GershowLab/trig3_board_pllphase_de0nano-firmware/board/de0-extender-pll/trig3_board_de0-nano - LTC6957.brd

## EAGLE design board/de0-extender-pll/trig3_board_de0-nano - LTC6957.brd (2023-12-06)

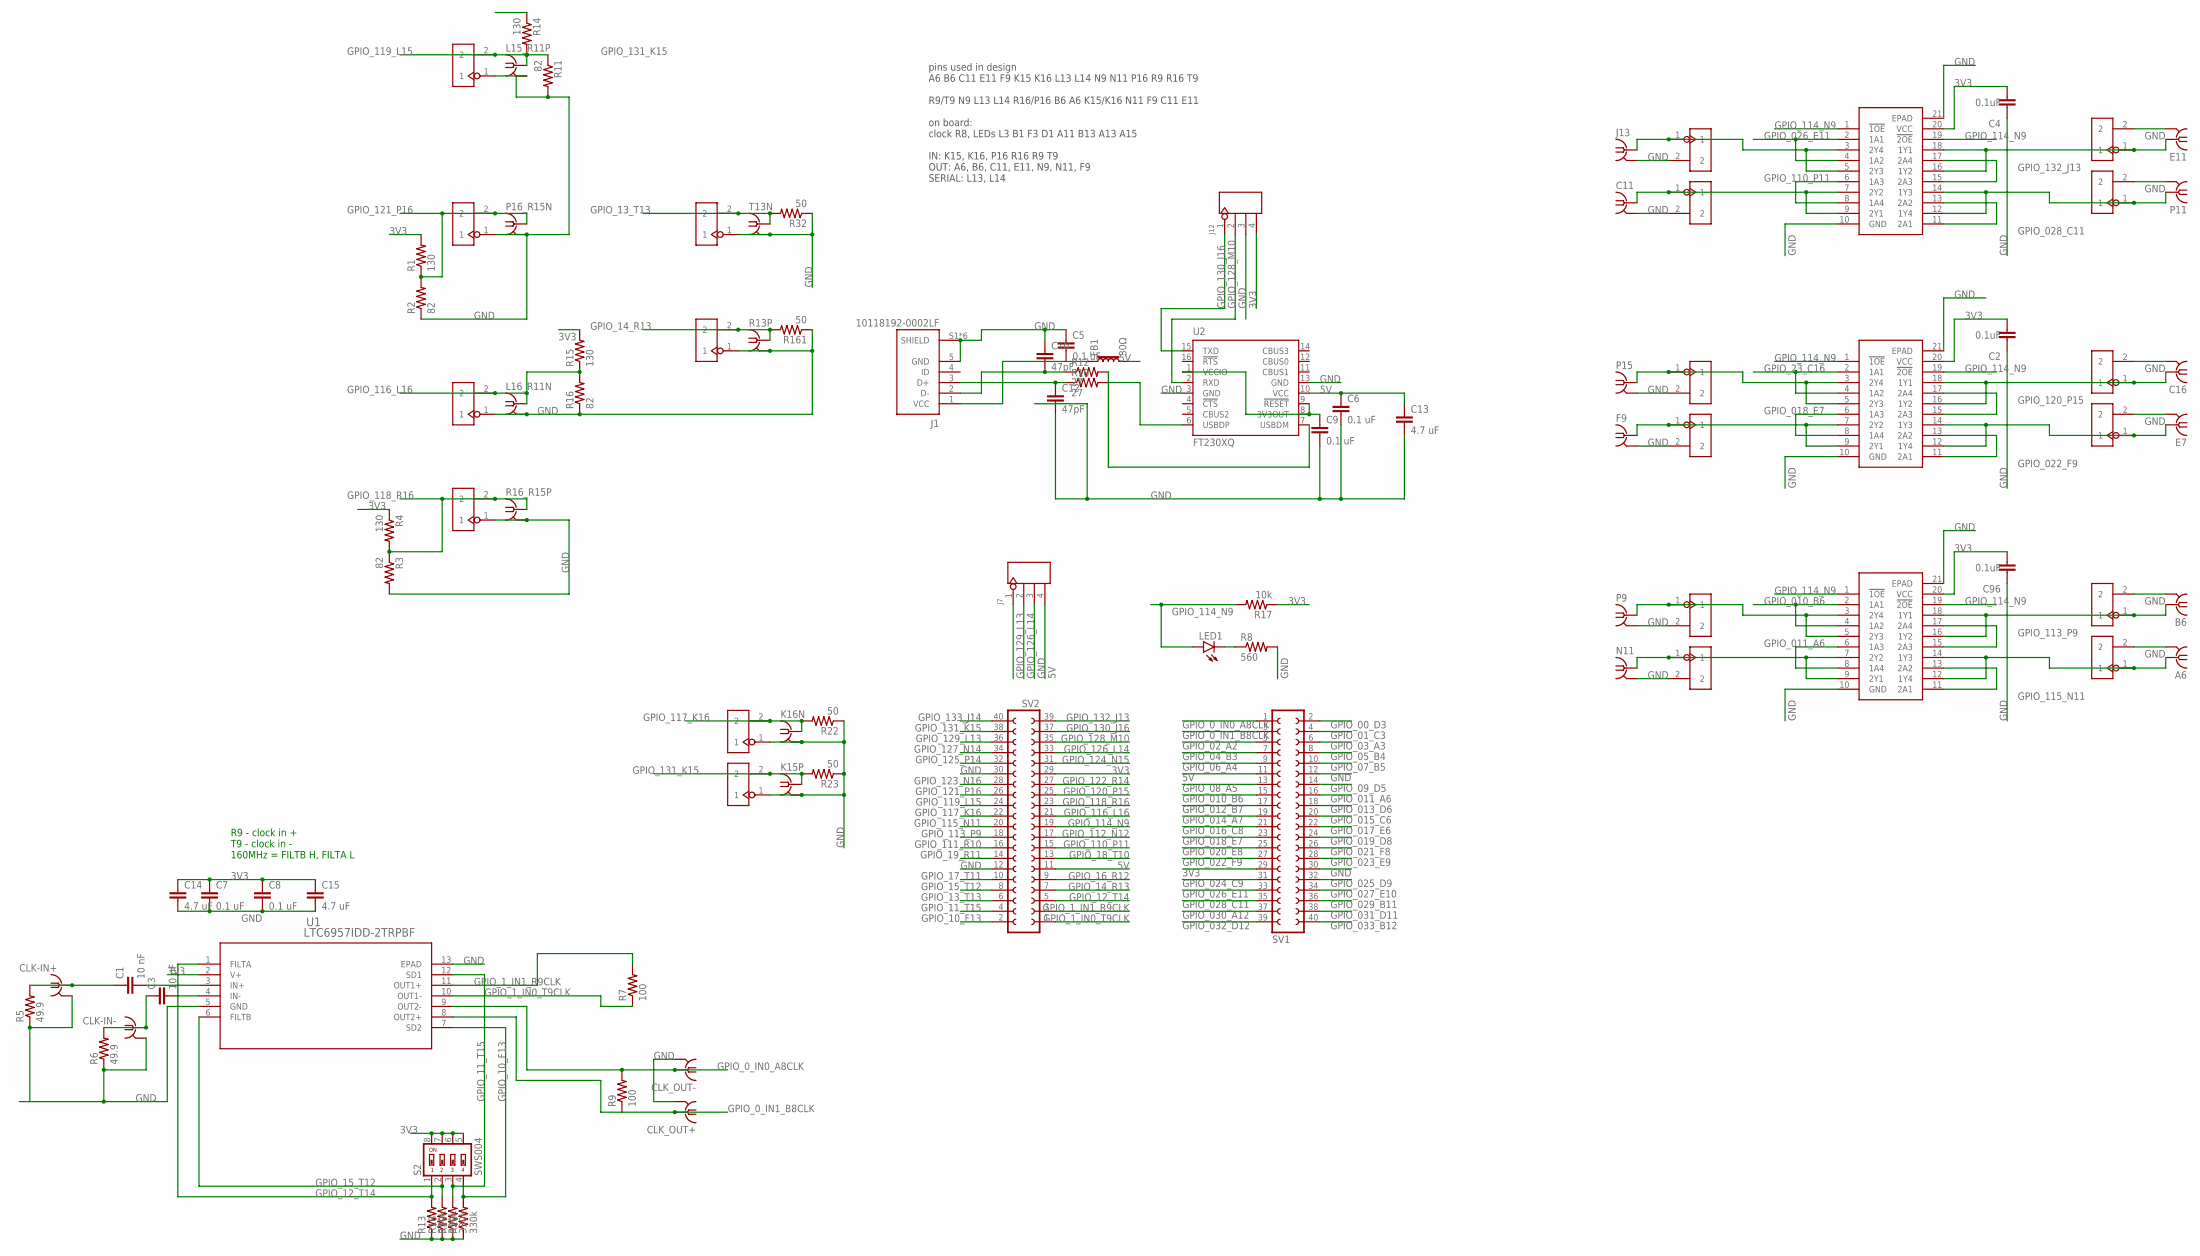
[picture p1: schematic trig3_board_de0-nano - LTC6957.sch]

Parts:
A6: BU-SMB-V; LCSC_PART# C496549
B6: BU-SMB-V; LCSC_PART# C496549
C1, C3: 10 nF; C0603; LCSC_PART# C57112
C2, C4, C96: 0.1uF; C0603; LCSC_PART# C14663
C5, C6, C7, C8, C9: 0.1 uF; C0603; LCSC_PART# C14663
C10, C12: 47pF; C0603; LCSC_PART# C1671
C11, C16: BU-SMB-V; LCSC_PART# C496549
C13, C14, C15: 4.7 uF; C0603; LCSC_PART# C19666
CLK-IN+: BU-SMB-V; LCSC_PART# C496549
CLK-IN-: BU-SMB-V; LCSC_PART# C496549
CLK_OUT+: BU-SMB-V; LCSC_PART# C496549
CLK_OUT-: BU-SMB-V; LCSC_PART# C496549
E7, E11: BU-SMB-V; LCSC_PART# C496549
F9: BU-SMB-V; LCSC_PART# C496549
FB1: 30Ω; 0603; LCSC_PART# C1002
J1: 10118192-0002LF; AMPHENOL_10118192-0002LF; LCSC_PART# C132564
J7, J12: 4p-2.54; H4-2.54
J13: BU-SMB-V; LCSC_PART# C496549
J17, J23, J24, J32, J34, J38, J42, J43: 2p-2.54; H2-2.54
K15P, K16N: BU-SMB-V; LCSC_PART# C496549
L15_R11P, L16_R11N: BU-SMB-V; LCSC_PART# C496549
LED1: red; SML0805; LCSC_PART# C84256
N11: BU-SMB-V; LCSC_PART# C496549
OJ41, OJ42, OJ43, OJ44, OJ57, OJ58, OJ59, OJ60, OJ73, OJ74, OJ75, OJ76: 2p-2.54; H2-2.54
P9, P11, P15, P16_R15N: BU-SMB-V; LCSC_PART# C496549
R1, R4, R14, R15: 130; R0603; LCSC_PART# C22796
R2, R3, R11, R16: 82; R0603; LCSC_PART# C23255
R5, R6: 49.9; R0603; LCSC_PART# C23185
R7, R9: 100; R0603; LCSC_PART# C22775
R8: 560; R0805; LCSC_PART# C28636
R10, R12: 27; R0603; LCSC_PART# C25190
R13, R18, R19, R20: 330k; R0603; LCSC_PART# C23137
R13P, R16_R15P: BU-SMB-V; LCSC_PART# C496549
R17: 10k; AXIAL-0.3
R22, R23, R32, R161: 50; AXIAL-0.3
S2: SWS004; SMS-004; LCSC_PART# C221954
SV1, SV2: FE20-2
T13N: BU-SMB-V; LCSC_PART# C496549
U1: LTC6957IDD-2TRPBF; DFN-12_DD_LIT; LCSC_PART# C689878
U2: FT230XQ; QFN16; LCSC_PART# C128629
U3, U4, U5: SN74LVTH244ARGYR; RGY20_3P05X2P05; LCSC_PART# C2869480

Connections:
3V3: C2.2, C4.2, C7.1, C8.1, C14.1, C15.1, C96.2, J12.4, R1.2, R4.1, R14.1, R15.2, R17.P$1 (1), S2.5, S2.6, S2.7, S2.8, SV1.29, SV2.29, U1.2 (V+), U3.20 (VCC), U4.20 (VCC), U5.20 (VCC)
5V: C6.1, C13.1, FB1.2, J7.4, SV1.11, SV2.11, U2.10 (VCC)
GND: A6.2, A6.3 (2), A6.4 (2), A6.5 (2), B6.2, B6.3 (2), B6.4 (2), B6.5 (2), C2.1, C4.1, C5.1, C6.2, C7.2, C8.2, C9.2, C10.1, C11.2, C11.3 (2), C11.4 (2), C11.5 (2), C12.2, C13.2, C14.2, C15.2, C16.2, C16.3 (2), C16.4 (2), C16.5 (2), C96.1, CLK-IN+.2, CLK-IN+.3 (2), CLK-IN+.4 (2), CLK-IN+.5 (2), CLK-IN-.2, CLK-IN-.3 (2), CLK-IN-.4 (2), CLK-IN-.5 (2), CLK_OUT+.2, CLK_OUT+.3 (2), CLK_OUT+.4 (2), CLK_OUT+.5 (2), CLK_OUT-.2, CLK_OUT-.3 (2), CLK_OUT-.4 (2), CLK_OUT-.5 (2), E7.2, E7.3 (2), E7.4 (2), E7.5 (2), E11.2, E11.3 (2), E11.4 (2), E11.5 (2), F9.2, F9.3 (2), F9.4 (2), F9.5 (2), J1.5 (GND), J1.S1 (SHIELD), J1.S2 (SHIELD), J1.S3 (SHIELD), J1.S4 (SHIELD), J1.S5 (SHIELD), J1.S6 (SHIELD), J7.3, J12.3, J13.2, J13.3 (2), J13.4 (2), J13.5 (2), J17.1, J23.1, J24.1, J32.1, J34.1, J38.1, J42.1, J43.1, K15P.2, K15P.3 (2), K15P.4 (2), K15P.5 (2), K16N.2, K16N.3 (2), K16N.4 (2), K16N.5 (2), L15_R11P.2, L15_R11P.3 (2), L15_R11P.4 (2), L15_R11P.5 (2), L16_R11N.2, L16_R11N.3 (2), L16_R11N.4 (2), L16_R11N.5 (2), N11.2, N11.3 (2), N11.4 (2), N11.5 (2), OJ41.2, OJ42.2, OJ43.2, OJ44.2, OJ57.2, OJ58.2, OJ59.2, OJ60.2, OJ73.2, OJ74.2, OJ75.2, OJ76.2, P9.2, P9.3 (2), P9.4 (2), P9.5 (2), P11.2, P11.3 (2), P11.4 (2), P11.5 (2), P15.2, P15.3 (2), P15.4 (2), P15.5 (2), P16_R15N.2, P16_R15N.3 (2), P16_R15N.4 (2), P16_R15N.5 (2), R2.1, R3.2, R5.1, R6.1, R8.2, R11.2, R13.1, R13P.2, R13P.3 (2), R13P.4 (2), R13P.5 (2), R16.1, R16_R15P.2, R16_R15P.3 (2), R16_R15P.4 (2), R16_R15P.5 (2), R18.1, R19.1, R20.1, R22.P$1 (1), R23.P$1 (1), R32.P$1 (1), R161.P$1 (1), SV1.12, SV1.30, SV2.12, SV2.30, T13N.2, T13N.3 (2), T13N.4 (2), T13N.5 (2), U1.5 (GND), U1.13 (EPAD), U2.3 (GND), U2.13 (GND), U3.10 (GND), U3.21 (EPAD), U4.10 (GND), U4.21 (EPAD), U5.10 (GND), U5.21 (EPAD)
GPIO_00_D3: SV1.2
GPIO_0_IN0_A8CLK: CLK_OUT-.1, R9.2, SV1.1, U1.9 (OUT2-)
GPIO_0_IN1_B8CLK: CLK_OUT+.1, R9.1, SV1.3, U1.8 (OUT2+)
GPIO_01_C3: SV1.4
GPIO_1_IN0_T9CLK: R7.1, SV2.1, U1.10 (OUT1-)
GPIO_1_IN1_R9CLK: R7.2, SV2.3, U1.11 (OUT1+)
GPIO_02_A2: SV1.5
GPIO_03_A3: SV1.6
GPIO_04_B3: SV1.7
GPIO_05_B4: SV1.8
GPIO_06_A4: SV1.9
GPIO_07_B5: SV1.10
GPIO_08_A5: SV1.13
GPIO_09_D5: SV1.14
GPIO_010_B6: SV1.15, U5.2 (1A1), U5.4 (1A2)
GPIO_10_F13: R20.2, S2.4, SV2.2, U1.7 (SD2)
GPIO_011_A6: SV1.16, U5.6 (1A3), U5.8 (1A4)
GPIO_11_T15: R19.2, S2.3, SV2.4, U1.12 (SD1)
GPIO_012_B7: SV1.17
GPIO_12_T14: R13.2, S2.1, SV2.5, U1.1 (FILTA)
GPIO_013_D6: SV1.18
GPIO_13_T13: J38.2, R32.P$2 (2), SV2.6, T13N.1
GPIO_014_A7: SV1.19
GPIO_14_R13: J17.2, R13P.1, R161.P$2 (2), SV2.7
GPIO_015_C6: SV1.20
GPIO_15_T12: R18.2, S2.2, SV2.8, U1.6 (FILTB)
GPIO_016_C8: SV1.21
GPIO_16_R12: SV2.9
GPIO_017_E6: SV1.22
GPIO_17_T11: SV2.10
GPIO_018_E7: SV1.23, U4.6 (1A3), U4.8 (1A4)
GPIO_18_T10: SV2.13
GPIO_019_D8: SV1.24
GPIO_19_R11: SV2.14
GPIO_020_E8: SV1.25
GPIO_021_F8: SV1.26
GPIO_022_F9: SV1.27, U4.11 (2A1), U4.13 (2A2)
GPIO_23_C16: U4.2 (1A1), U4.4 (1A2)
GPIO_023_E9: SV1.28
GPIO_024_C9: SV1.31
GPIO_025_D9: SV1.32
GPIO_026_E11: SV1.33, U3.2 (1A1), U3.4 (1A2)
GPIO_027_E10: SV1.34
GPIO_028_C11: SV1.35, U3.11 (2A1), U3.13 (2A2)
GPIO_029_B11: SV1.36
GPIO_030_A12: SV1.37
GPIO_031_D11: SV1.38
GPIO_032_D12: SV1.39
GPIO_033_B12: SV1.40
GPIO_110_P11: SV2.15, U3.6 (1A3), U3.8 (1A4)
GPIO_111_R10: SV2.16
GPIO_112_N12: SV2.17
GPIO_113_P9: SV2.18, U5.15 (2A3), U5.17 (2A4)
GPIO_114_N9: LED1.A, R17.P$2 (2), SV2.19, U3.1 (!1OE), U3.19 (!2OE), U4.1 (!1OE), U4.19 (!2OE), U5.1 (!1OE), U5.19 (!2OE)
GPIO_115_N11: SV2.20, U5.11 (2A1), U5.13 (2A2)
GPIO_116_L16: J32.2, L16_R11N.1, R15.1, R16.2, SV2.21
GPIO_117_K16: J23.2, K16N.1, R22.P$2 (2), SV2.22
GPIO_118_R16: J34.2, R3.1, R4.2, R16_R15P.1, SV2.23
GPIO_119_L15: J43.2, L15_R11P.1, R11.1, R14.2, SV2.24
GPIO_120_P15: SV2.25, U4.15 (2A3), U4.17 (2A4)
GPIO_121_P16: J42.2, P16_R15N.1, R1.1, R2.2, SV2.26
GPIO_122_R14: SV2.27
GPIO_123_N16: SV2.28
GPIO_124_N15: SV2.31
GPIO_125_P14: SV2.32
GPIO_126_L14: J7.2, SV2.33
GPIO_127_N14: SV2.34
GPIO_128_M10: J12.2, SV2.35, U2.2 (RXD)
GPIO_129_L13: J7.1, SV2.36
GPIO_130_J16: J12.1, SV2.37, U2.15 (TXD)
GPIO_131_K15: J24.2, K15P.1, R23.P$2 (2), SV2.38
GPIO_132_J13: SV2.39, U3.15 (2A3), U3.17 (2A4)
GPIO_133_J14: SV2.40
unnamed: C1.1, CLK-IN+.1, R5.2
unnamed: C3.1, CLK-IN-.1, R6.2
unnamed: C1.2, U1.3 (IN+)
unnamed: C3.2, U1.4 (IN-)
unnamed: C5.2, FB1.1, J1.1 (VCC)
unnamed: C12.1, J1.3 (D+), R10.1
unnamed: LED1.C, R8.1
unnamed: C10.2, J1.2 (D-), R12.1
unnamed: R10.2, U2.6 (USBDP)
unnamed: R12.2, U2.7 (USBDM)
unnamed: C9.1, U2.1 (VCCIO), U2.8 (3V3OUT), U2.9 (!RESET)
OUT21: B6.1, OJ44.1, U5.16 (1Y2), U5.18 (1Y1)
OUT22: A6.1, OJ43.1, U5.12 (1Y4), U5.14 (1Y3)
OUT23: OJ41.1, P9.1, U5.3 (2Y4), U5.5 (2Y3)
OUT24: N11.1, OJ42.1, U5.7 (2Y2), U5.9 (2Y1)
OUT29: C16.1, OJ60.1, U4.16 (1Y2), U4.18 (1Y1)
OUT30: E7.1, OJ59.1, U4.12 (1Y4), U4.14 (1Y3)
OUT31: OJ57.1, P15.1, U4.3 (2Y4), U4.5 (2Y3)
OUT32: F9.1, OJ58.1, U4.7 (2Y2), U4.9 (2Y1)
OUT37: E11.1, OJ76.1, U3.16 (1Y2), U3.18 (1Y1)
OUT38: OJ75.1, P11.1, U3.12 (1Y4), U3.14 (1Y3)
OUT39: J13.1, OJ73.1, U3.3 (2Y4), U3.5 (2Y3)
OUT40: C11.1, OJ74.1, U3.7 (2Y2), U3.9 (2Y1)

Notes on the sheet:
pins used in design A6 B6 C11 E11 F9 K15 K16 L13 L14 N9 N11 P16 R9 R16 T9 R9/T9 N9 L13 L14 R16/P16 B6 A6 K15/K16 N11 F9 C11 E11 on board: clock R8, LEDs L3 B1 F3 D1 A11 B13 A13 A15 IN: K15, K16, P16 R16 R9 T9 OUT: A6, B6, C11, E11, N9, N11, F9 SERIAL: L13, L14
R9 - clock in + T9 - clock in - 160MHz = FILTB H, FILTA L

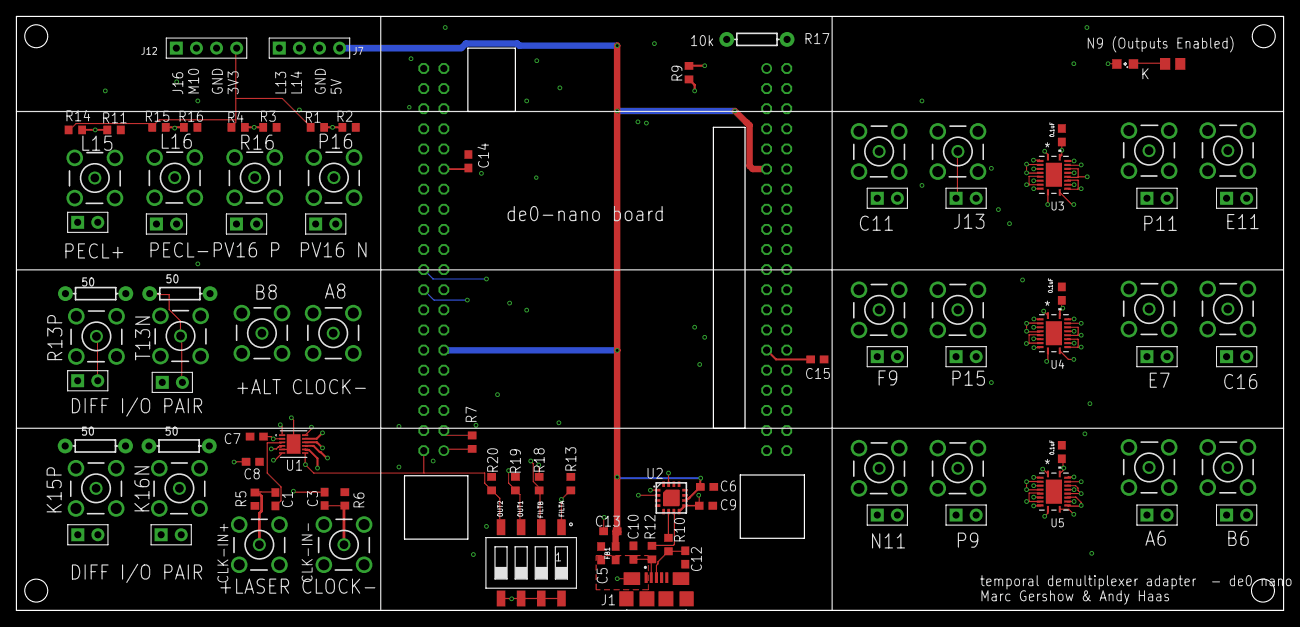
[picture p2: board trig3_board_de0-nano - LTC6957.brd from above]

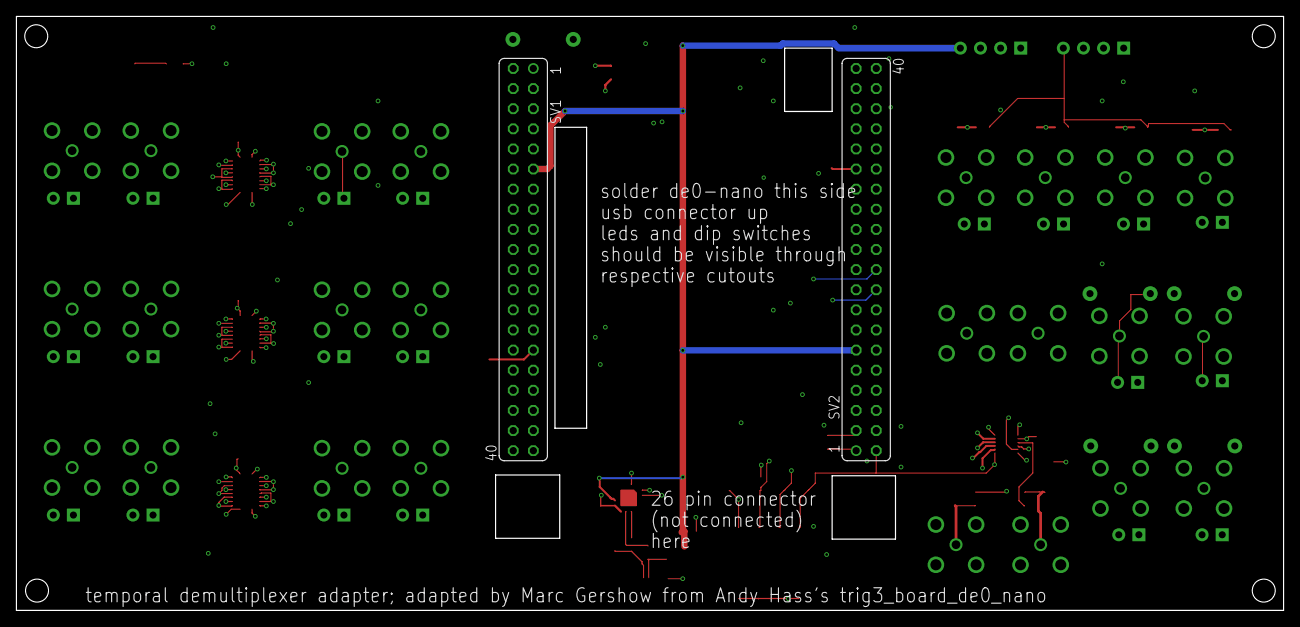
[picture p3: board trig3_board_de0-nano - LTC6957.brd from below]

Board: 4 copper layers, 160.0 x 75.0 mm, 96 parts (2 on the bottom side), 59 nets.
