GershowLab/trig3_board_pllphase_de0nano-firmware/board/de0-extender-pll/trig3_board_de0-nano.brd

## EAGLE design board/de0-extender-pll/trig3_board_de0-nano.brd (2023-11-16)

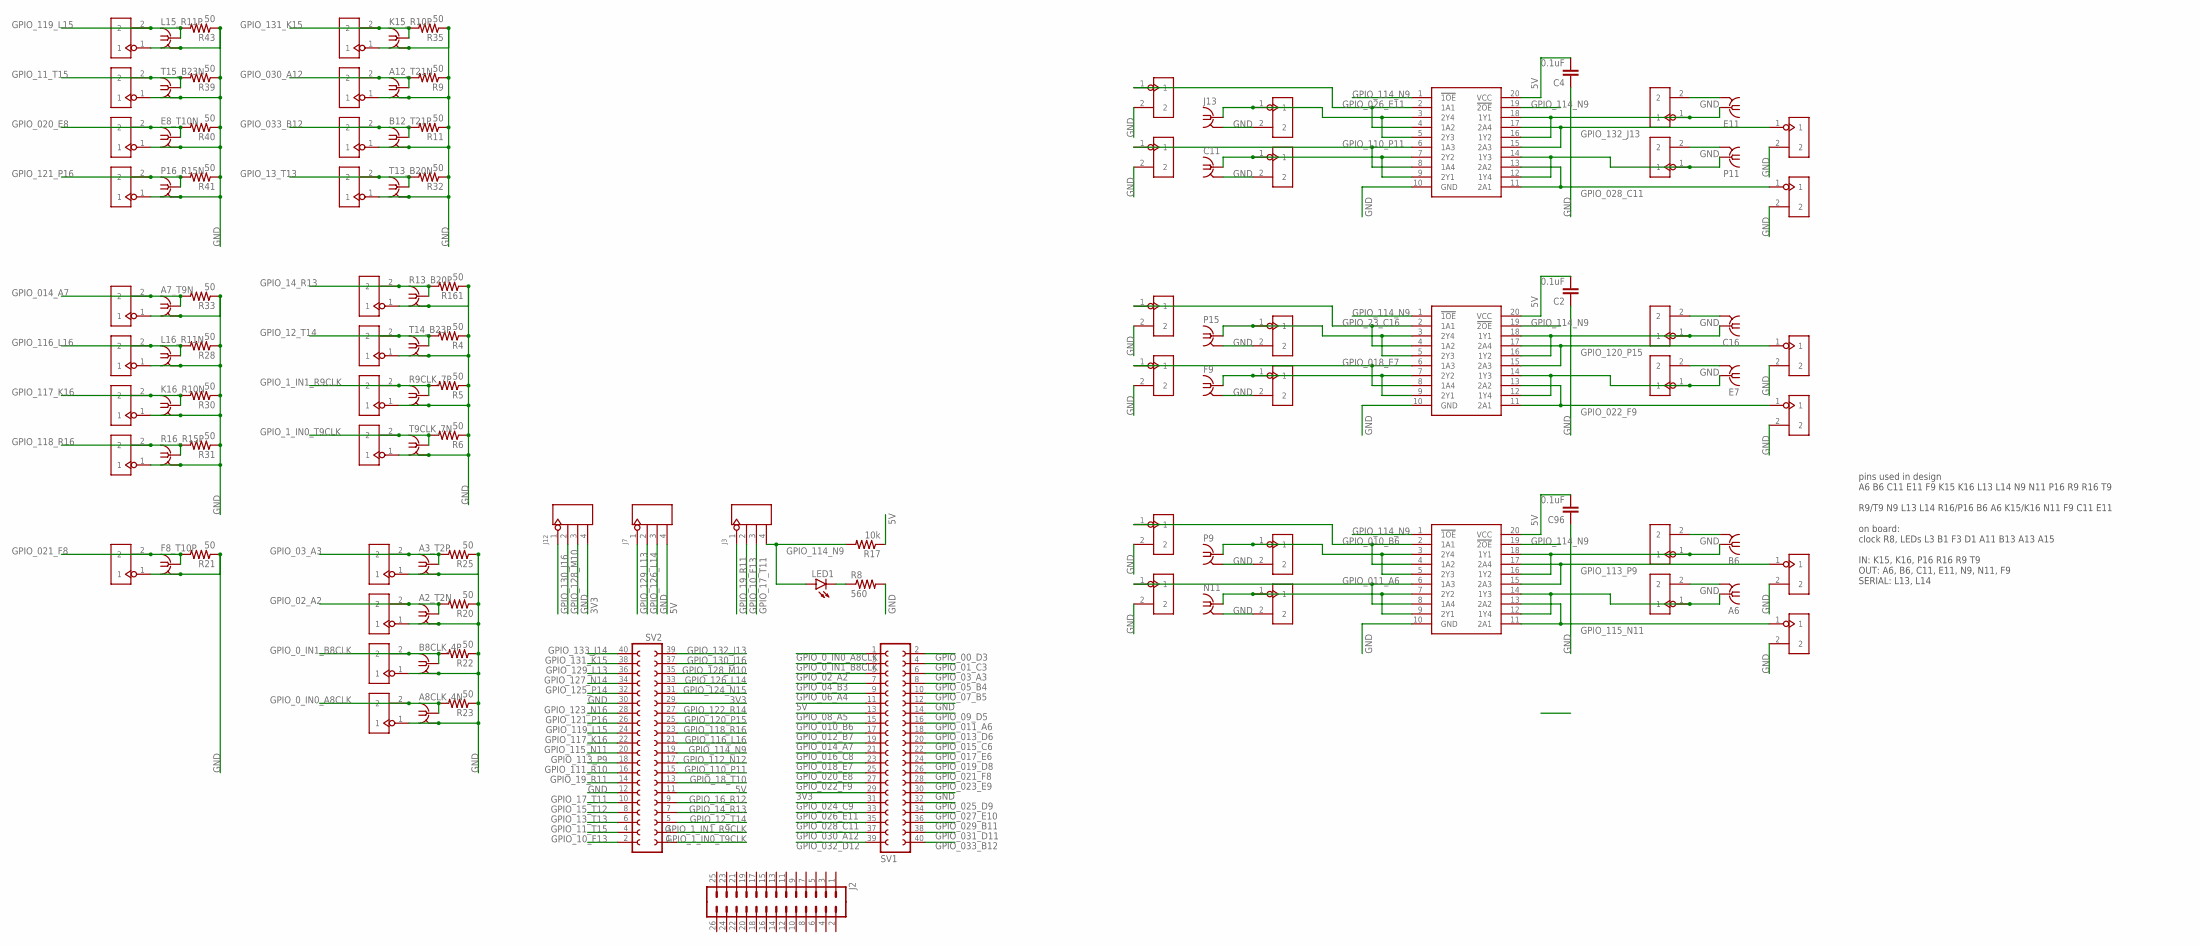
[picture p4: schematic trig3_board_de0-nano.sch]

Parts:
A2_T2N, A3_T2P, A6, A7_T9N, A8CLK_4N, A12_T21N: BU-SMB-V
B6, B8CLK_4P, B12_T21P: BU-SMB-V
C2, C4, C96: 0.1uF; 0805
C11, C16: BU-SMB-V
E7, E8_T10N, E11: BU-SMB-V
F8_T10P, F9: BU-SMB-V
J2: M13X22X13; 2X13
J3, J7, J12: 4p-2.54; H4-2.54
J4, J5, J6, J17, J18, J22, J23, J24, J25, J32, J33, J34, J35, J36, J37, J38, J39, J40, J41, J42, J43: 2p-2.54; H2-2.54
J13: BU-SMB-V
K15_R10P, K16_R10N: BU-SMB-V
L15_R11P, L16_R11N: BU-SMB-V
LED1: red; CHIP-LED0805
N11: BU-SMB-V
OJ41, OJ42, OJ43, OJ44, OJ45, OJ46, OJ47, OJ48, OJ57, OJ58, OJ59, OJ60, OJ61, OJ62, OJ63, OJ64, OJ73, OJ74, OJ75, OJ76, OJ77, OJ78, OJ79, OJ80: 2p-2.54; H2-2.54
P9, P11, P15, P16_R15N: BU-SMB-V
R4, R5, R6, R9, R11, R20, R21, R22, R23, R25, R28, R30, R31, R32, R33, R35, R39, R40, R41, R43, R161: 50; AXIAL-0.3
R8: 560; R0805
R9CLK_7P, R13_B20P, R16_R15P: BU-SMB-V
R17: 10k; AXIAL-0.3
SV1, SV2: FE20-2
T9CLK_7N, T13_B20N, T14_B23P, T15_B23N: BU-SMB-V
VSLUE5, VSLUE7, VSLUE9: SN74ACT244DW; SOIC127P1030X265-20N

Connections:
3V3: J12.4, SV1.29, SV2.29
5V: C2.2, C4.2, C96.2, J7.4, R17.P$1 (1), SV1.11, SV2.11, VSLUE5.20 (VCC), VSLUE7.20 (VCC), VSLUE9.20 (VCC)
GND: A2_T2N.2, A2_T2N.3 (2), A2_T2N.4 (2), A2_T2N.5 (2), A3_T2P.2, A3_T2P.3 (2), A3_T2P.4 (2), A3_T2P.5 (2), A6.2, A6.3 (2), A6.4 (2), A6.5 (2), A7_T9N.2, A7_T9N.3 (2), A7_T9N.4 (2), A7_T9N.5 (2), A8CLK_4N.2, A8CLK_4N.3 (2), A8CLK_4N.4 (2), A8CLK_4N.5 (2), A12_T21N.2, A12_T21N.3 (2), A12_T21N.4 (2), A12_T21N.5 (2), B6.2, B6.3 (2), B6.4 (2), B6.5 (2), B8CLK_4P.2, B8CLK_4P.3 (2), B8CLK_4P.4 (2), B8CLK_4P.5 (2), B12_T21P.2, B12_T21P.3 (2), B12_T21P.4 (2), B12_T21P.5 (2), C2.1, C4.1, C11.2, C11.3 (2), C11.4 (2), C11.5 (2), C16.2, C16.3 (2), C16.4 (2), C16.5 (2), C96.1, E7.2, E7.3 (2), E7.4 (2), E7.5 (2), E8_T10N.2, E8_T10N.3 (2), E8_T10N.4 (2), E8_T10N.5 (2), E11.2, E11.3 (2), E11.4 (2), E11.5 (2), F8_T10P.2, F8_T10P.3 (2), F8_T10P.4 (2), F8_T10P.5 (2), F9.2, F9.3 (2), F9.4 (2), F9.5 (2), J4.1, J5.1, J6.1, J7.3, J12.3, J13.2, J13.3 (2), J13.4 (2), J13.5 (2), J17.1, J18.1, J22.1, J23.1, J24.1, J25.1, J32.1, J33.1, J34.1, J35.1, J36.1, J37.1, J38.1, J39.1, J40.1, J41.1, J42.1, J43.1, K15_R10P.2, K15_R10P.3 (2), K15_R10P.4 (2), K15_R10P.5 (2), K16_R10N.2, K16_R10N.3 (2), K16_R10N.4 (2), K16_R10N.5 (2), L15_R11P.2, L15_R11P.3 (2), L15_R11P.4 (2), L15_R11P.5 (2), L16_R11N.2, L16_R11N.3 (2), L16_R11N.4 (2), L16_R11N.5 (2), N11.2, N11.3 (2), N11.4 (2), N11.5 (2), OJ41.2, OJ42.2, OJ43.2, OJ44.2, OJ45.2, OJ46.2, OJ47.2, OJ48.2, OJ57.2, OJ58.2, OJ59.2, OJ60.2, OJ61.2, OJ62.2, OJ63.2, OJ64.2, OJ73.2, OJ74.2, OJ75.2, OJ76.2, OJ77.2, OJ78.2, OJ79.2, OJ80.2, P9.2, P9.3 (2), P9.4 (2), P9.5 (2), P11.2, P11.3 (2), P11.4 (2), P11.5 (2), P15.2, P15.3 (2), P15.4 (2), P15.5 (2), P16_R15N.2, P16_R15N.3 (2), P16_R15N.4 (2), P16_R15N.5 (2), R4.P$1 (1), R5.P$1 (1), R6.P$1 (1), R8.2, R9.P$1 (1), R9CLK_7P.2, R9CLK_7P.3 (2), R9CLK_7P.4 (2), R9CLK_7P.5 (2), R11.P$1 (1), R13_B20P.2, R13_B20P.3 (2), R13_B20P.4 (2), R13_B20P.5 (2), R16_R15P.2, R16_R15P.3 (2), R16_R15P.4 (2), R16_R15P.5 (2), R20.P$1 (1), R21.P$1 (1), R22.P$1 (1), R23.P$1 (1), R25.P$1 (1), R28.P$1 (1), R30.P$1 (1), R31.P$1 (1), R32.P$1 (1), R33.P$1 (1), R35.P$1 (1), R39.P$1 (1), R40.P$1 (1), R41.P$1 (1), R43.P$1 (1), R161.P$1 (1), SV1.12, SV1.30, SV2.12, SV2.30, T9CLK_7N.2, T9CLK_7N.3 (2), T9CLK_7N.4 (2), T9CLK_7N.5 (2), T13_B20N.2, T13_B20N.3 (2), T13_B20N.4 (2), T13_B20N.5 (2), T14_B23P.2, T14_B23P.3 (2), T14_B23P.4 (2), T14_B23P.5 (2), T15_B23N.2, T15_B23N.3 (2), T15_B23N.4 (2), T15_B23N.5 (2), VSLUE5.10 (GND), VSLUE7.10 (GND), VSLUE9.10 (GND)
GPIO_00_D3: SV1.2
GPIO_0_IN0_A8CLK: A8CLK_4N.1, J24.2, R23.P$2 (2), SV1.1
GPIO_0_IN1_B8CLK: B8CLK_4P.1, J23.2, R22.P$2 (2), SV1.3
GPIO_01_C3: SV1.4
GPIO_1_IN0_T9CLK: J6.2, R6.P$2 (2), SV2.1, T9CLK_7N.1
GPIO_1_IN1_R9CLK: J5.2, R5.P$2 (2), R9CLK_7P.1, SV2.3
GPIO_02_A2: A2_T2N.1, J22.2, R20.P$2 (2), SV1.5
GPIO_03_A3: A3_T2P.1, J25.2, R25.P$2 (2), SV1.6
GPIO_04_B3: SV1.7
GPIO_05_B4: SV1.8
GPIO_06_A4: SV1.9
GPIO_07_B5: SV1.10
GPIO_08_A5: SV1.13
GPIO_09_D5: SV1.14
GPIO_010_B6: OJ47.1, SV1.15, VSLUE5.2 (1A1), VSLUE5.4 (1A2)
GPIO_10_F13: J3.2, SV2.2
GPIO_011_A6: OJ48.1, SV1.16, VSLUE5.6 (1A3), VSLUE5.8 (1A4)
GPIO_11_T15: J40.2, R39.P$2 (2), SV2.4, T15_B23N.1
GPIO_012_B7: SV1.17
GPIO_12_T14: J4.2, R4.P$2 (2), SV2.5, T14_B23P.1
GPIO_013_D6: SV1.18
GPIO_13_T13: J38.2, R32.P$2 (2), SV2.6, T13_B20N.1
GPIO_014_A7: A7_T9N.1, J35.2, R33.P$2 (2), SV1.19
GPIO_14_R13: J17.2, R13_B20P.1, R161.P$2 (2), SV2.7
GPIO_015_C6: SV1.20
GPIO_15_T12: SV2.8
GPIO_016_C8: SV1.21
GPIO_16_R12: SV2.9
GPIO_017_E6: SV1.22
GPIO_17_T11: J3.3, SV2.10
GPIO_018_E7: OJ64.1, SV1.23, VSLUE7.6 (1A3), VSLUE7.8 (1A4)
GPIO_18_T10: SV2.13
GPIO_019_D8: SV1.24
GPIO_19_R11: J3.1, SV2.14
GPIO_020_E8: E8_T10N.1, J41.2, R40.P$2 (2), SV1.25
GPIO_021_F8: F8_T10P.1, J18.2, R21.P$2 (2), SV1.26
GPIO_022_F9: OJ62.1, SV1.27, VSLUE7.11 (2A1), VSLUE7.13 (2A2)
GPIO_23_C16: OJ63.1, VSLUE7.2 (1A1), VSLUE7.4 (1A2)
GPIO_023_E9: SV1.28
GPIO_024_C9: SV1.31
GPIO_025_D9: SV1.32
GPIO_026_E11: OJ79.1, SV1.33, VSLUE9.2 (1A1), VSLUE9.4 (1A2)
GPIO_027_E10: SV1.34
GPIO_028_C11: OJ78.1, SV1.35, VSLUE9.11 (2A1), VSLUE9.13 (2A2)
GPIO_029_B11: SV1.36
GPIO_030_A12: A12_T21N.1, J36.2, R9.P$2 (2), SV1.37
GPIO_031_D11: SV1.38
GPIO_032_D12: SV1.39
GPIO_033_B12: B12_T21P.1, J37.2, R11.P$2 (2), SV1.40
GPIO_110_P11: OJ80.1, SV2.15, VSLUE9.6 (1A3), VSLUE9.8 (1A4)
GPIO_111_R10: SV2.16
GPIO_112_N12: SV2.17
GPIO_113_P9: OJ45.1, SV2.18, VSLUE5.15 (2A3), VSLUE5.17 (2A4)
GPIO_114_N9: J3.4, LED1.A, R17.P$2 (2), SV2.19, VSLUE5.1 (!1OE), VSLUE5.19 (!2OE), VSLUE7.1 (!1OE), VSLUE7.19 (!2OE), VSLUE9.1 (!1OE), VSLUE9.19 (!2OE)
GPIO_115_N11: OJ46.1, SV2.20, VSLUE5.11 (2A1), VSLUE5.13 (2A2)
GPIO_116_L16: J32.2, L16_R11N.1, R28.P$2 (2), SV2.21
GPIO_117_K16: J33.2, K16_R10N.1, R30.P$2 (2), SV2.22
GPIO_118_R16: J34.2, R16_R15P.1, R31.P$2 (2), SV2.23
GPIO_119_L15: J43.2, L15_R11P.1, R43.P$2 (2), SV2.24
GPIO_120_P15: OJ61.1, SV2.25, VSLUE7.15 (2A3), VSLUE7.17 (2A4)
GPIO_121_P16: J42.2, P16_R15N.1, R41.P$2 (2), SV2.26
GPIO_122_R14: SV2.27
GPIO_123_N16: SV2.28
GPIO_124_N15: SV2.31
GPIO_125_P14: SV2.32
GPIO_126_L14: J7.2, SV2.33
GPIO_127_N14: SV2.34
GPIO_128_M10: J12.2, SV2.35
GPIO_129_L13: J7.1, SV2.36
GPIO_130_J16: J12.1, SV2.37
GPIO_131_K15: J39.2, K15_R10P.1, R35.P$2 (2), SV2.38
GPIO_132_J13: OJ77.1, SV2.39, VSLUE9.15 (2A3), VSLUE9.17 (2A4)
GPIO_133_J14: SV2.40
unnamed: LED1.C, R8.1
OUT21: B6.1, OJ44.1, VSLUE5.16 (1Y2), VSLUE5.18 (1Y1)
OUT22: A6.1, OJ43.1, VSLUE5.12 (1Y4), VSLUE5.14 (1Y3)
OUT23: OJ41.1, P9.1, VSLUE5.3 (2Y4), VSLUE5.5 (2Y3)
OUT24: N11.1, OJ42.1, VSLUE5.7 (2Y2), VSLUE5.9 (2Y1)
OUT29: C16.1, OJ60.1, VSLUE7.16 (1Y2), VSLUE7.18 (1Y1)
OUT30: E7.1, OJ59.1, VSLUE7.12 (1Y4), VSLUE7.14 (1Y3)
OUT31: OJ57.1, P15.1, VSLUE7.3 (2Y4), VSLUE7.5 (2Y3)
OUT32: F9.1, OJ58.1, VSLUE7.7 (2Y2), VSLUE7.9 (2Y1)
OUT37: E11.1, OJ76.1, VSLUE9.16 (1Y2), VSLUE9.18 (1Y1)
OUT38: OJ75.1, P11.1, VSLUE9.12 (1Y4), VSLUE9.14 (1Y3)
OUT39: J13.1, OJ73.1, VSLUE9.3 (2Y4), VSLUE9.5 (2Y3)
OUT40: C11.1, OJ74.1, VSLUE9.7 (2Y2), VSLUE9.9 (2Y1)

Notes on the sheet:
pins used in design A6 B6 C11 E11 F9 K15 K16 L13 L14 N9 N11 P16 R9 R16 T9 R9/T9 N9 L13 L14 R16/P16 B6 A6 K15/K16 N11 F9 C11 E11 on board: clock R8, LEDs L3 B1 F3 D1 A11 B13 A13 A15 IN: K15, K16, P16 R16 R9 T9 OUT: A6, B6, C11, E11, N9, N11, F9 SERIAL: L13, L14

Board: 4 copper layers, 114 parts (2 on the bottom side), 57 nets, no tracks yet.
