GershowLab/trig3_board_pllphase_de0nano-firmware/(commit log)

2023-11-15 annotating firmware, working on board
    [pin connections.csv, trig3_board_de0-nano.brd, trig3_board_de0-nano.sch]
2023-11-15 removed some unused inputs
    kept all clock inputs and some extra inputs
    [trig3_board_de0-nano.brd, trig3_board_de0-nano.sch]
2023-11-15 removed many outputs and negative voltage
    [trig3_board_de0-nano.brd, trig3_board_de0-nano.sch]
2023-11-15 more removal
    [trig3_board_de0-nano.brd, trig3_board_de0-nano.sch]
2023-11-16 going to delete more ins/outs
    [trig3_board_de0-nano.brd, trig3_board_de0-nano.sch]
2023-11-16 reduced board ready for autoroute
    creating board with ltc carrier now
    [trig3_board_de0-nano - LTC6957.brd, trig3_board_de0-nano - LTC6957.sch]
2023-11-22 ltc6957 based board starting
    [trig3_board_de0-nano - LTC6957.sch]
2023-11-27 fixed pecl termination
    [trig3_board_de0-nano - LTC6957.brd, trig3_board_de0-nano - LTC6957.sch]
2023-12-01 more work on board
    [trig3_board_de0-nano - LTC6957.brd, trig3_board_de0-nano - LTC6957.sch]
2023-12-02 ready to autoroute
    [trig3_board_de0-nano - LTC6957.brd, trig3_board_de0-nano - LTC6957.sch]
2023-12-02 autoroute attempt 2
    [trig3_board_de0-nano - LTC6957.brd, trig3_board_de0-nano - LTC6957.sch]
2023-12-02 Update trig3_board_de0-nano - LTC6957.brd
    [trig3_board_de0-nano - LTC6957.brd]
2023-12-02 removed unnecessary header
    [trig3_board_de0-nano - LTC6957.brd, trig3_board_de0-nano - LTC6957.sch]
2023-12-02 routed - now needs aesthetic cleanup
    [trig3_board_de0-nano - LTC6957.brd]
2023-12-03 fixed auto-router top layer nonsense
    [trig3_board_de0-nano - LTC6957.brd, trig3_board_de0-nano - LTC6957.sch]
2023-12-04 removed wire stubs, tried to fix package rotation
    rotated footprints in library but change did not propagate to pcb
    [trig3_board_de0-nano - LTC6957.brd, trig3_board_de0-nano - LTC6957.sch]
2023-12-04 rotated footprints and cosmetic updates to board
    [trig3_board_de0-nano - LTC6957.brd, trig3_board_de0-nano - LTC6957.sch]
2023-12-04 ready for ordering
    will probably need to do one last check
    [trig3_board_de0-nano - LTC6957.brd, trig3_board_de0-nano - LTC6957.sch, trig3_board_de0-nano - LTC6957_top_bom.csv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]
2023-12-05 fixed usb connection error; changed connector; change dip switch part
    added sd1, sd2, filta, filtb to gpio pins also
    [trig3_board_de0-nano - LTC6957.brd, trig3_board_de0-nano - LTC6957.sch, trig3_board_de0-nano - LTC6957_top_bom.csv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]
2023-12-05 modified silksccreen
    [trig3_board_de0-nano - LTC6957.brd]
2023-12-06 one change to silkscreen; added 4.7 uF capacitors to 3.3V header connections
    [trig3_board_de0-nano - LTC6957.brd, trig3_board_de0-nano - LTC6957.sch, trig3_board_de0-nano - LTC6957_top_bom.csv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]
2023-12-06 changed via hole size to reduce costs
    [trig3_board_de0-nano - LTC6957.brd, trig3_board_de0-nano - LTC6957.sch]
2023-12-19 connected dip switches on carrier to outputs in code
    lots of warnings on compilation now, presumably related to version upgrade of quartus
    ---
    SW version 29
2023-12-22 disabled onboard clock and change laser clock source to B8/A8
