GershowLab/trig3_board_pllphase_de0nano-firmware/(notices)

Notices in the files:
parts and their libraries:
SparkFun-Capacitors: Licensing: Creative Commons ShareAlike 4.0 International - https://creativecommons.org/licenses/by-sa/4.0
ltc6957-2: COPYRIGHT: Copyright (C) 2023 Ultra Librarian. All rights reserved.
